EasonwangAI/smart-knee-rt-thread/firmware/releases/README.md

# 原归档提供的 STM32 固件

`stm32-archive-20261006.bin` 是此次压缩包 `Debug/rtthread.bin` 的原样副本，大小为 466,020 字节。

本次没有重新编译它，也没有据此声称源码和二进制可重复构建一致。文件来源与 SHA-256 记录在 [VERSIONS.md](../../docs/VERSIONS.md)。

这是 STM32F407VE 护膝硬件的固件，不能用于星火一号能力测评工程或 ESP32。烧录前应确认供电、芯片型号及接线与当前工程一致。
