EasonwangAI/smart-knee-rt-thread/docs/FILE_MANIFEST.md

# 文件清单

本次整理日期：2026-10-06。完整逐文件路径、大小和 SHA-256 见 [FILE_MANIFEST.json](FILE_MANIFEST.json)。清单自身不参与递归校验。

| 分类 | 文件数 | 大小 MiB |
| --- | ---: | ---: |
| 仓库根目录 | 5 | 0.02 |
| data | 25 | 11.13 |
| docs | 18 | 0.04 |
| firmware | 3 | 0.45 |
| ESP32 无线源码 | 2 | 0.04 |
| STM32 工程及依赖 | 2587 | 63.27 |
| Android 源码与安装包 | 42 | 0.21 |
| software | 27 | 15.62 |

总计 2709 个清单条目。各文件均小于 GitHub 单文件 100 MB 限制。原 1.30 GB 压缩包未上传，公开的是分类后的源码与必要下载文件。

板端源文件与输入归档一致；ESP32 与 APK 均验证 SHA-256 相同。运行库只调整直接姓名和本机路径，不改变数字特征值。旧训练工具与样本按原仓库保留。
