EasonwangAI/smart-knee-rt-thread/docs/source-notes/MOTION_FAST_V3_README_CN.md

# 动作计数快速版 V3

## 目的

本工程针对约 0.8 至 1 秒完成一次深蹲的快速演示。它从 `test_pro719_dbmatch_motion_v2` 单独复制，未覆盖 V2 和原屏幕稳定工程。本文件记录的是 2026-07-20 更新后的安全上限参数。

## 修改内容

- MPU6050 仍以 20 ms 周期更新，即 50 Hz，采样周期没有降低。
- 动作候选启动幅度：相对站立基线 4.0 度。
- 有效动作最低幅度：6.0 度。
- 峰值累计回落 1.2 度后确认起身。
- 回到站立基线 5.0 度以内后确认动作结束。
- 启动阶段必须连续呈现至少每个采样 0.2 度的下蹲趋势，静止抖动不能仅靠越过角度阈值启动。
- 启动、起身和回正确认均缩短为 2 个 MPU 样本，约 40 ms。
- 最短有效动作时间降为 250 ms。
- 动作状态最长允许 4 秒，超时后自动复位。
- 每次有效计数后设置 150 ms 防重复间隔。
- 增加 `count_armed`：只有回到顶端后才允许开始下一次，防止缩短确认时间后重复计数。
- 每个通过有效性检查的动作必须二选一：绝对峰值达到 24 度归为 `SQUAT`，否则归为 `DEADLIFT`；`UNKNOWN` 只用于尚未完成的动作预览。因此始终满足 `TOTAL = SQUAT + DEAD`。
- 疲劳报警阈值统一为 70：连续窗口疲劳分数达到 70 时进入报警判定，每次动作的峰值疲劳达到 70 时触发动作级马达报警。
- 圆屏检查周期由 500 ms 降为 80 ms，即从 2 Hz 提高到约 12.5 Hz。
- 圆屏驱动文件没有修改，显示仍采用局部刷新。

## 离线检查

- 构造连续 10 次深蹲的 20 ms 角度轨迹：每次 1 秒和每次 0.8 秒均为 10/10；每次 0.6 秒时保护逻辑会拒绝部分动作。
- 本地 11 名受试者、27 段历史记录中，11 人和 26 段能形成动作闭环。
- 历史回放最高约 39.6 次/分钟，没有超过 40 次/分钟出现明显爆计数。
- 历史记录缺少逐次人工真值，因此只能用于阈值筛选，不能宣称为计数准确率。

## 实物测试

1. 上电后保持直立静止至少 2 秒，让 MPU6050 建立基线。
2. 先静止站立 10 秒，屏幕次数必须保持为 0。
3. 连续完成 3 次深蹲，每次约 1 秒，每次回到直立位置，预期计数为 3。
4. 连续完成 10 次深蹲，同时由另一人手工计数。
5. 原地晃腿、轻微屈膝各测试 10 秒，观察是否误计数。
6. 若 10 次只识别 8 至 9 次，先检查顶端是否真正回正，不要立即继续降低阈值。
7. 若晃腿也加数，快速版过于灵敏，应烧回 V2 或原稳定版。

## 固件

- 文件：`Debug/rtthread.bin`
- 大小：`518832` 字节
- SHA-256：`9122CBDFB92E5C41190D95847E39C99F622CFD20F729B712FF39CAF7532F2414`

## 回退

- 屏幕稳定数据库版：`../test_pro719_dbmatch/Debug/rtthread.bin`

现场保留屏幕稳定数据库版作为最终兜底。V2 工程源码仍然保留，但不要把它当作现场唯一回退固件。
