EasonwangAI/smart-knee-rt-thread/docs/source-notes/MOTION_V2_README_CN.md

# 动作计数 V2 实验版说明

## 工程定位

- 工程名：`test_pro719_dbmatch_motion_v2`
- 底版：`test_pro719_dbmatch`，即 2026-07-18 晚确认圆屏正常的版本加数据库匹配功能
- 原底版没有被覆盖，出现问题时可直接烧回原工程的 `Debug/rtthread.bin`
- 本实验版只修改 `applications/main.c` 中的动作计数状态机，并修正一个动作质量评分恒加 1 的明显错误
- `applications/gc9a01.c` 与 `applications/tft_gc9a01.c` 未修改

## 为什么旧逻辑容易不计数

旧逻辑使用上电校准后的绝对角度：动作必须超过 5 度，最后还必须回到 3 度以内；进入上升阶段还要求单个 MPU 采样点立刻回落超过 2 度。历史数据中，不同人的护膝松紧、安装角度和站立姿态差异较大，不少完整深蹲无法回到绝对 3 度以内，状态会长期停留在 `BOT` 或 `ASC`。

## V2 计数规则

1. MPU6050 校准结束时记录当前站立角度。
2. 静止在站立姿态附近时，缓慢跟踪不超过 3 度的绑带漂移。
3. 相对站立基线连续变化 5 度，进入动作候选。
4. 动作相对变化至少达到 8 度，才允许最终计数。
5. 不再要求某一个采样点突然反向；从峰值累计回落 2 度并连续确认后，进入上升阶段。
6. 回到站立基线 3 度以内并连续确认后，动作闭环并加 1。
7. 动作总时长小于 700 毫秒时拒绝计数，避免抖动或走动造成重复计数。
8. 状态超过 8 秒仍未闭环时自动放弃并重建站立基线，避免永久卡在 `BOT/ASC`。

深蹲与硬拉的动作类型阈值仍沿用底版：绝对峰值达到 30 度显示 `SQUAT`，15 至 30 度显示 `DEADLIFT`。本轮先解决“是否计数”，没有同时重做动作分类模型。

## 历史数据回放

阈值选择使用了本地数据库中的 11 名受试者、27 段 `LIVE` 角度记录。选定阈值在离线回放中覆盖 11 名受试者和 26 段记录；剩余 1 段只有约 0.6 分钟，角度范围约 6.2 至 11.4 度，没有形成可识别的完整周期。回放中没有出现超过每分钟 30 次的异常计数。

这些串口记录约每 60 毫秒保存一次，而板端 MPU 状态机每 20 毫秒更新一次，并且历史数据没有人工逐次标注真实动作数。因此回放结果只用于排除明显过严、明显爆计数的阈值，不能作为计数准确率。

## 上板测试顺序

1. 导入工程后确认工程名为 `test_pro719_dbmatch_motion_v2`。
2. 烧录 `Debug/rtthread.bin`。
3. 上电后的 MPU6050 校准期间保持直立、膝盖不动，至少等待 2 秒后再开始动作。
4. 先做 5 次速度正常、每次完整站直的深蹲，观察屏幕次数是否从 0 增加到 5。
5. 静止站立 20 秒，再原地轻微晃腿 10 秒；次数不应自行增加。
6. 再做 5 次较浅深蹲和 5 次较慢深蹲，记录漏计或多计发生在哪一类动作。
7. 串口 `LIVE` 行中的 `mot_phase` 应按 `STAND -> DESC -> BOT/ASC -> STAND` 变化；每个有效动作结束时应出现一条 `REP` 行。

## 快速回退

如果屏幕异常、次数连续乱跳或其他功能退化，不要继续现场调阈值，直接烧回：

`../test_pro719_dbmatch/Debug/rtthread.bin`

该文件是本次修改前保留的屏幕稳定、数据库匹配版本。

## 当前固件

- 文件：`Debug/rtthread.bin`
- 大小：`518028` 字节
- SHA-256：`BAA32FB665F2BAB3285E830BD8ADEFDE1FA5E76CB1AA21D883FA35ED3B27185C`
- 生成时间：`2026-07-19 23:33:35`
