EasonwangAI/smart-knee-rt-thread/docs/source-notes/BUILD_INFO_CN.md

# 构建信息

- 工程名：`test_pro719_dbmatch`
- 底版：`D:/RT-ThreadStudio/workspace/test_pro7_18_working_lcd_ok_20260718`
- 生成日期：2026-07-19
- 已验证固件：`Debug/rtthread.bin`
- 固件大小：518032 字节
- SHA-256：`CDF62101AA995D44A8171F9A171CA0E974DFF9DB88A027852209E604FAB63C28`
- 圆屏驱动与稳定底版一致：是

导入 RT-Thread Studio 后，工程显示名称应为 `test_pro719_dbmatch`。当前 `Debug`
目录已经包含可烧录固件。若 Studio 重新生成构建文件，请执行一次完整构建后再下载。
