EasonwangAI/smart-knee-rt-thread/software/pc_tools_and_training/action_validation_features.csv

mav | rms | wl | iemg | var | zc | ssc | swing | tilt_std | tilt_p95 | tilt_zc | gyro_mean | gyro_max | gyro_std | acc_std | duration_s | live_rows | source | t0_ms | t1_ms | raw_label | true_action | pred_action | pred_merged | true_merged | prob_LegExt | prob_Squat | prob_Walking | pred_confidence
0.02007041658673967 | 0.02488127136836493 | 30.006662426250323 | 29.22252655029296 | 0.0006190776649062165 | 0.0 | 0.0 | 0.10000000000000142 | 0.03027019790651334 | 0.10000000000000142 | 0.0 | 4.071813438553027 | 4.230206240151551 | 0.06734167263874408 | 0.0015222417029412561 | 2.912 | 49 | D:\mpu_wave\unused_files_20260601\session_20260528_173730.log | 3575689 | 3578689 | Squat | Squat | Squat | LegMovement | LegMovement | 0.3338820775650519 | 0.6661179224349482 | 0.0 | 0.6661179224349482
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
