EasonwangAI/smart-knee-rt-thread/firmware/rt-thread-studio-project/applications/fatigue_db_builtin_profiles.h

#ifndef __FATIGUE_DB_BUILTIN_PROFILES_H__
#define __FATIGUE_DB_BUILTIN_PROFILES_H__

typedef struct
{
    const char *person_id;
    const char *fatigue_level;
    uint16_t sample_count;
    float z[8];
} fatigue_db_builtin_profile_t;

/* Robust medians from local labeled rows, grouped by person and fatigue level.
 * Groups with fewer than three samples and one extreme outlier group are omitted.
 */
static const fatigue_db_builtin_profile_t builtin_profiles[] =
{
    {"local_01", "low", 27U, {0.6331164f, 0.4976155f, 0.4125709f, 0.5204175f, -0.1513685f, -0.2881150f, -0.5465484f, -0.2525947f}},
    {"local_01", "medium", 17U, {0.7849310f, 0.5830626f, 0.5848839f, 0.5577312f, -0.0299176f, -0.3096164f, -0.5864076f, -0.3113565f}},
    {"local_01", "none", 8U, {-0.6451006f, -0.5584989f, -0.4337424f, -0.4489252f, -0.7572206f, -1.0329506f, -1.3351905f, -1.5876630f}},
    {"local_02", "low", 41U, {0.1347510f, 0.1967497f, 0.3363244f, -0.2920206f, -0.0161738f, 0.4717233f, 0.4214600f, 0.7628093f}},
    {"local_02", "medium", 42U, {0.4170363f, 0.4212754f, 0.4505190f, -0.1309740f, 0.0651675f, 0.5600168f, 0.4584721f, 0.7628093f}},
    {"local_02", "none", 3U, {-2.0178411f, -1.9606683f, -1.6941801f, -0.5302380f, -0.7572206f, -1.0394266f, -1.0305526f, -1.5876630f}},
    {"local_03", "high", 3U, {0.6706254f, 0.5265563f, 0.4448936f, 0.6845768f, 0.2954474f, -0.1898687f, 0.1424458f, 0.7628093f}},
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
};

#define FATIGUE_DB_BUILTIN_PROFILE_COUNT \
    ((uint16_t)(sizeof(builtin_profiles) / sizeof(builtin_profiles[0])))

#endif /* __FATIGUE_DB_BUILTIN_PROFILES_H__ */
