EasonwangAI/smart-knee-rt-thread/firmware/rt-thread-studio-project/drivers/board.c

/*
 * Copyright (c) 2006-2026, RT-Thread Development Team
 *
 * SPDX-License-Identifier: Apache-2.0
 *
 * Change Logs:
 * Date           Author       Notes
 * 2026-05-07     RealThread   first version
 */

#include <rtthread.h>
#include <board.h>
#include <drv_common.h>
#include "stm32f4xx_hal.h"

#ifndef RT_WEAK
#define RT_WEAK rt_weak
#endif

RT_WEAK void rt_hw_board_init()
{
    extern void hw_board_init(char *clock_src, int32_t clock_src_freq, int32_t clock_target_freq);

    /* Heap initialization */
#if defined(RT_USING_HEAP)
    rt_system_heap_init((void *) HEAP_BEGIN, (void *) HEAP_END);
#endif

    hw_board_init(BSP_CLOCK_SOURCE, BSP_CLOCK_SOURCE_FREQ_MHZ, BSP_CLOCK_SYSTEM_FREQ_MHZ);

    /* Set the shell console output device */
#if defined(RT_USING_DEVICE) && defined(RT_USING_CONSOLE)
    rt_console_set_device(RT_CONSOLE_DEVICE_NAME);
#endif

    /* Board underlying hardware initialization */
#ifdef RT_USING_COMPONENTS_INIT
    rt_components_board_init();
#endif

}

#ifdef BSP_USING_ADC1
void HAL_ADC_MspInit(ADC_HandleTypeDef *hadc)
{
    GPIO_InitTypeDef GPIO_InitStruct = {0};

    if (hadc->Instance != ADC1)
    {
        return;
    }

    __HAL_RCC_ADC1_CLK_ENABLE();
    __HAL_RCC_GPIOC_CLK_ENABLE();

    /* PC0 = ADC1_IN10 (medial), PC1 = ADC1_IN11 (lateral). */
    GPIO_InitStruct.Pin = GPIO_PIN_0 | GPIO_PIN_1;
    GPIO_InitStruct.Mode = GPIO_MODE_ANALOG;
    GPIO_InitStruct.Pull = GPIO_NOPULL;
    HAL_GPIO_Init(GPIOC, &GPIO_InitStruct);
}

void HAL_ADC_MspDeInit(ADC_HandleTypeDef *hadc)
{
    if (hadc->Instance != ADC1)
    {
        return;
    }

    __HAL_RCC_ADC1_CLK_DISABLE();
    HAL_GPIO_DeInit(GPIOC, GPIO_PIN_0 | GPIO_PIN_1);
}
#endif

#ifdef BSP_USING_SDIO
void HAL_SD_MspInit(SD_HandleTypeDef *hsd)
{
    GPIO_InitTypeDef GPIO_InitStruct = {0};

    if (hsd->Instance != SDIO)
    {
        return;
    }

    __HAL_RCC_SDIO_CLK_ENABLE();
    __HAL_RCC_GPIOC_CLK_ENABLE();
    __HAL_RCC_GPIOD_CLK_ENABLE();
    __HAL_RCC_DMA2_CLK_ENABLE();

    GPIO_InitStruct.Pin = GPIO_PIN_8 | GPIO_PIN_9 | GPIO_PIN_10 |
                          GPIO_PIN_11 | GPIO_PIN_12;
    GPIO_InitStruct.Mode = GPIO_MODE_AF_PP;
    GPIO_InitStruct.Pull = GPIO_PULLUP;
    GPIO_InitStruct.Speed = GPIO_SPEED_FREQ_VERY_HIGH;
    GPIO_InitStruct.Alternate = GPIO_AF12_SDIO;
    HAL_GPIO_Init(GPIOC, &GPIO_InitStruct);

    GPIO_InitStruct.Pin = GPIO_PIN_2;
    HAL_GPIO_Init(GPIOD, &GPIO_InitStruct);
}

void HAL_SD_MspDeInit(SD_HandleTypeDef *hsd)
{
    if (hsd->Instance != SDIO)
    {
        return;
    }

    __HAL_RCC_SDIO_CLK_DISABLE();
    HAL_GPIO_DeInit(GPIOC, GPIO_PIN_8 | GPIO_PIN_9 | GPIO_PIN_10 |
                           GPIO_PIN_11 | GPIO_PIN_12);
    HAL_GPIO_DeInit(GPIOD, GPIO_PIN_2);
}
#endif
