EasonwangAI/smart-knee-rt-thread/(commit log)

2026-07-08 Initial open-source release
    [P03_fatigue_clean_features.csv, P05_fatigue_clean_features.csv, action_validation_features.csv, action_windows.csv, ads1292_capture.csv, combined_all_common_features.csv, combined_clean_p03_p05_2s.csv, fatigue_emg_features.csv]
2026-10-06 Organize updated STM32 firmware, ESP32 Wi-Fi bridge and Android app
    [app_icon.xml, kconfig-language.txt, kconfig.txt, live.csv, matches.csv, person_profiles.csv, reference_features.csv, reps.csv]
